aloksethi/nucleo_glue_board/README.md

# Nucleo Glue Board

A small pcb which sits on top of NUCLEO-F429ZI board.
It connects to the two morpho connectors (CN12 and CN11) and provides a handy way to connect to the power and RF board.
also provides 4 reference currents
