aloksethi/nucleo_glue_board/extension_board.pdf

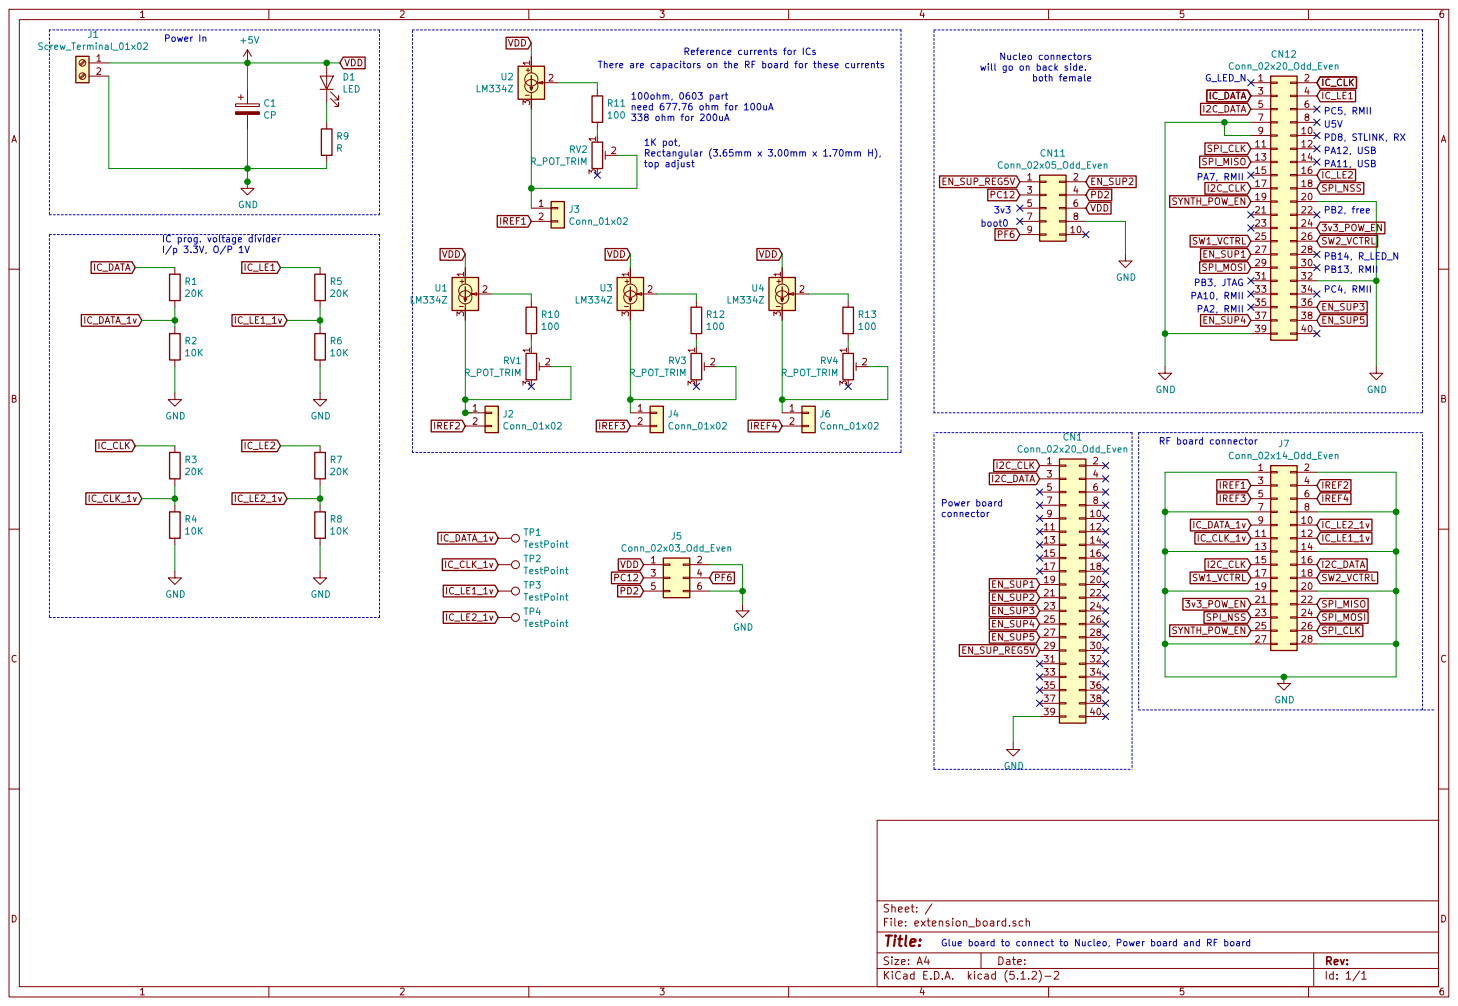
[picture p1: page 1]

boot0PF6 Reference currents for ICs TP1 TestPoint IC_DATA_1v

There are capacitors on the RF board for these currents

100ohm, 0603 part need 677.76 ohm for 100uA
338 ohm for 200uA

IC prog. voltage divider

Power board connector VDD

PB13, RMII PC4, RMII PA2, RMII PA10, RMII PB3, JTAG
