aloksethi/nucleo_glue_board/extension_board.kicad_pcb

## KiCad design extension_board.kicad_pcb (2021-06-22)

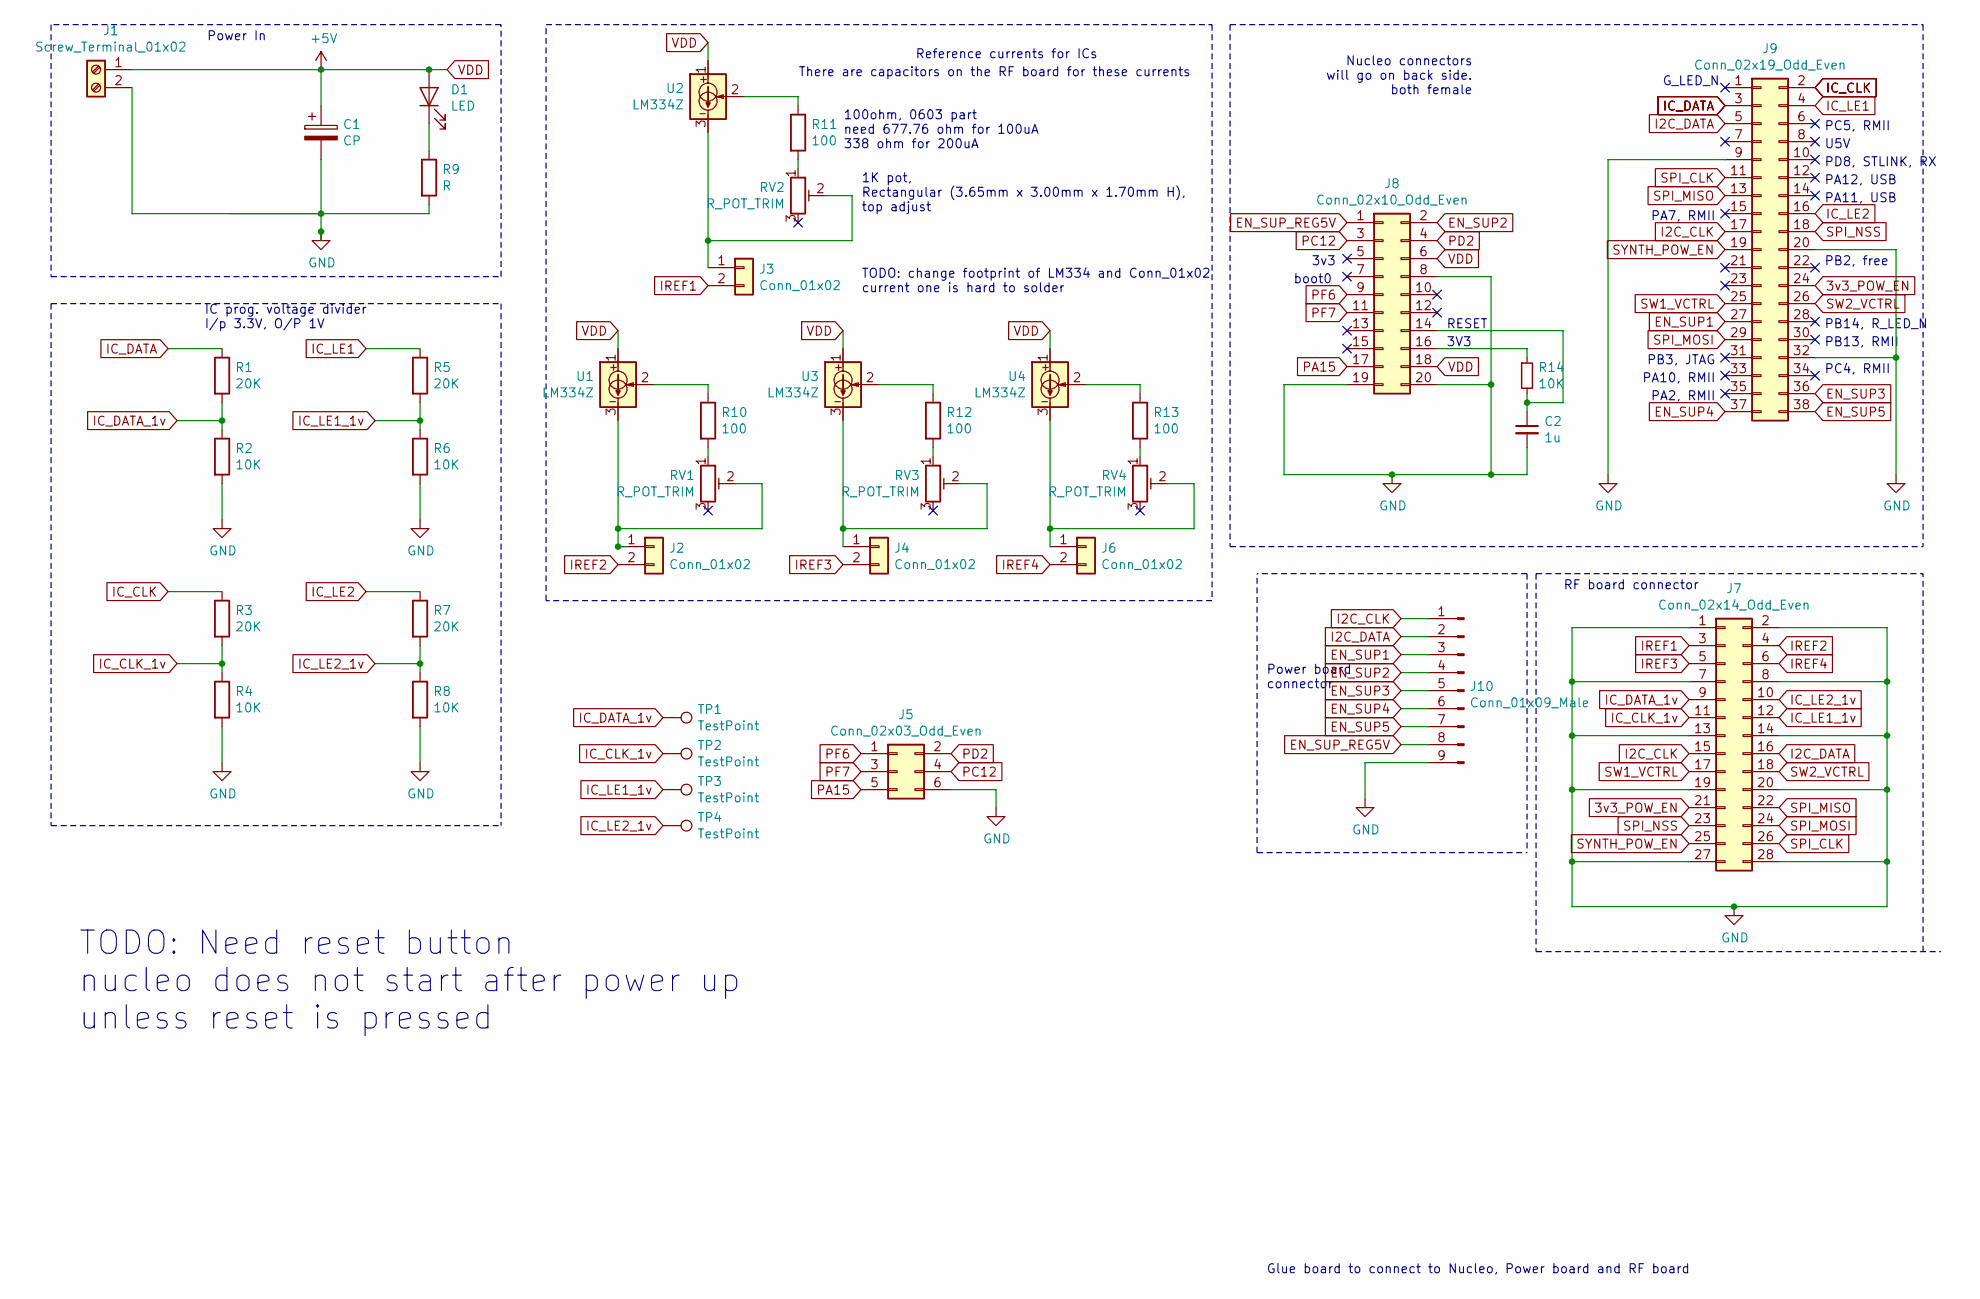
[picture p2: schematic extension_board.sch]

Parts:
C1: CP; CP_Elec_4x5.8
C2: 1u; C_0805_2012Metric_Pad1.15x1.40mm_HandSolder
D1: LED; LED_0805_2012Metric_Pad1.15x1.40mm_HandSolder
J1: Screw_Terminal_01x02; Term_Block_1x2_P5.08MM
J2, J3, J4, J6: Conn_01x02; PinHeader_1x02_P2.54mm_Vertical
J5: Conn_02x03_Odd_Even; PinHeader_2x03_P2.54mm_Vertical_SMD
J7: Conn_02x14_Odd_Even; PinHeader_2x14_P2.54mm_Vertical_SMD
J8: Conn_02x10_Odd_Even; PinHeader_2x10_P2.54mm_Vertical
J9: Conn_02x19_Odd_Even; PinHeader_2x19_P2.54mm_Vertical
J10: Conn_01x09_Male; PinHeader_1x09_P2.54mm_Vertical_SMD_Pin1Left
R1, R3, R5, R7: 20K; R_0805_2012Metric_Pad1.15x1.40mm_HandSolder
R2, R4, R6, R8, R14: 10K; R_0805_2012Metric_Pad1.15x1.40mm_HandSolder
R9: R; R_0805_2012Metric_Pad1.15x1.40mm_HandSolder
R10, R11, R12, R13: 100; R_0603_1608Metric_Pad1.05x0.95mm_HandSolder
RV1, RV2, RV3, RV4: R_POT_TRIM; Trimpot_3.8mmx3.6mm_TC33X-2-103E
TP1, TP2, TP3, TP4: TestPoint; TestPoint_Pad_1.0x1.0mm
U1, U2, U3, U4: LM334Z; TO-92_Inline_Wide

Connections:
3v3_POW_EN: J7.21, J9.24
EN_SUP1: J9.27, J10.3
EN_SUP2: J8.2, J10.4
EN_SUP3: J9.36, J10.5
EN_SUP4: J9.37, J10.6
EN_SUP5: J9.38, J10.7
EN_SUP_REG5V: J8.1, J10.8
GND: C1.2, C2.2, J1.2, J5.6, J7.1, J7.2, J7.7, J7.8, J7.13, J7.14, J7.19, J7.20, J7.27, J7.28, J8.8, J8.19, J8.20, J9.9, J9.20, J9.32, J10.9, R2.2, R4.2, R6.2, R8.2, R9.2
I2C_CLK: J7.15, J9.17, J10.1
I2C_DATA: J7.16, J9.5, J10.2
IC_CLK: J9.2, R3.1
IC_CLK_1v: J7.11, R3.2, R4.1, TP2.1
IC_DATA: J9.3, R1.1
IC_DATA_1v: J7.9, R1.2, R2.1, TP1.1
IC_LE1: J9.4, R5.1
IC_LE1_1v: J7.12, R5.2, R6.1, TP3.1
IC_LE2: J9.16, R7.1
IC_LE2_1v: J7.10, R7.2, R8.1, TP4.1
IREF1: J3.2, J7.3
IREF2: J2.2, J7.4
IREF3: J4.2, J7.5
IREF4: J6.2, J7.6
unnamed: C2.1, J8.14, R14.2
unnamed: D1.1 (K), R9.1
unnamed: J2.1, RV1.2, U1.3
unnamed: J3.1, RV2.2, U2.3
unnamed: J4.1, RV3.2, U3.3
unnamed: J6.1, RV4.2, U4.3
unnamed: J8.16, R14.1
unnamed: R10.1, U1.2
unnamed: R10.2, RV1.1
unnamed: R11.1, U2.2
unnamed: R11.2, RV2.1
unnamed: R12.1, U3.2
unnamed: R12.2, RV3.1
unnamed: R13.1, U4.2
unnamed: R13.2, RV4.1
PA15: J5.5, J8.17
PC12: J5.4, J8.3
PD2: J5.2, J8.4
PF6: J5.1, J8.9
PF7: J5.3, J8.11
SPI_CLK: J7.26, J9.11
SPI_MISO: J7.22, J9.13
SPI_MOSI: J7.24, J9.29
SPI_NSS: J7.23, J9.18
SW1_VCTRL: J7.17, J9.25
SW2_VCTRL: J7.18, J9.26
SYNTH_POW_EN: J7.25, J9.19
VDD: C1.1, D1.2 (A), J1.1, J8.6, J8.18, U1.1, U2.1, U3.1, U4.1

Notes on the sheet:
Glue board to connect to Nucleo, Power board and RF board
Power In
Nucleo connectors will go on back side. both female
RF board connector
IC prog. voltage divider I/p 3.3V, O/P 1V
100ohm, 0603 part need 677.76 ohm for 100uA 338 ohm for 200uA
1K pot, Rectangular (3.65mm x 3.00mm x 1.70mm H), top adjust
Power board connector
PC5, RMII
U5V
PD8, STLINK, RX
PA12, USB
PA11, USB
PB2, free
PB14, R_LED_N
G_LED_N
PB13, RMII
PC4, RMII
PA2, RMII
PA10, RMII
PB3, JTAG
PA7, RMII
3v3
boot0
Reference currents for ICs
There are capacitors on the RF board for these currents
TODO: change footprint of LM334 and Conn_01x02 current one is hard to solder
TODO: Need reset button nucleo does not start after power up unless reset is pressed
RESET
3V3

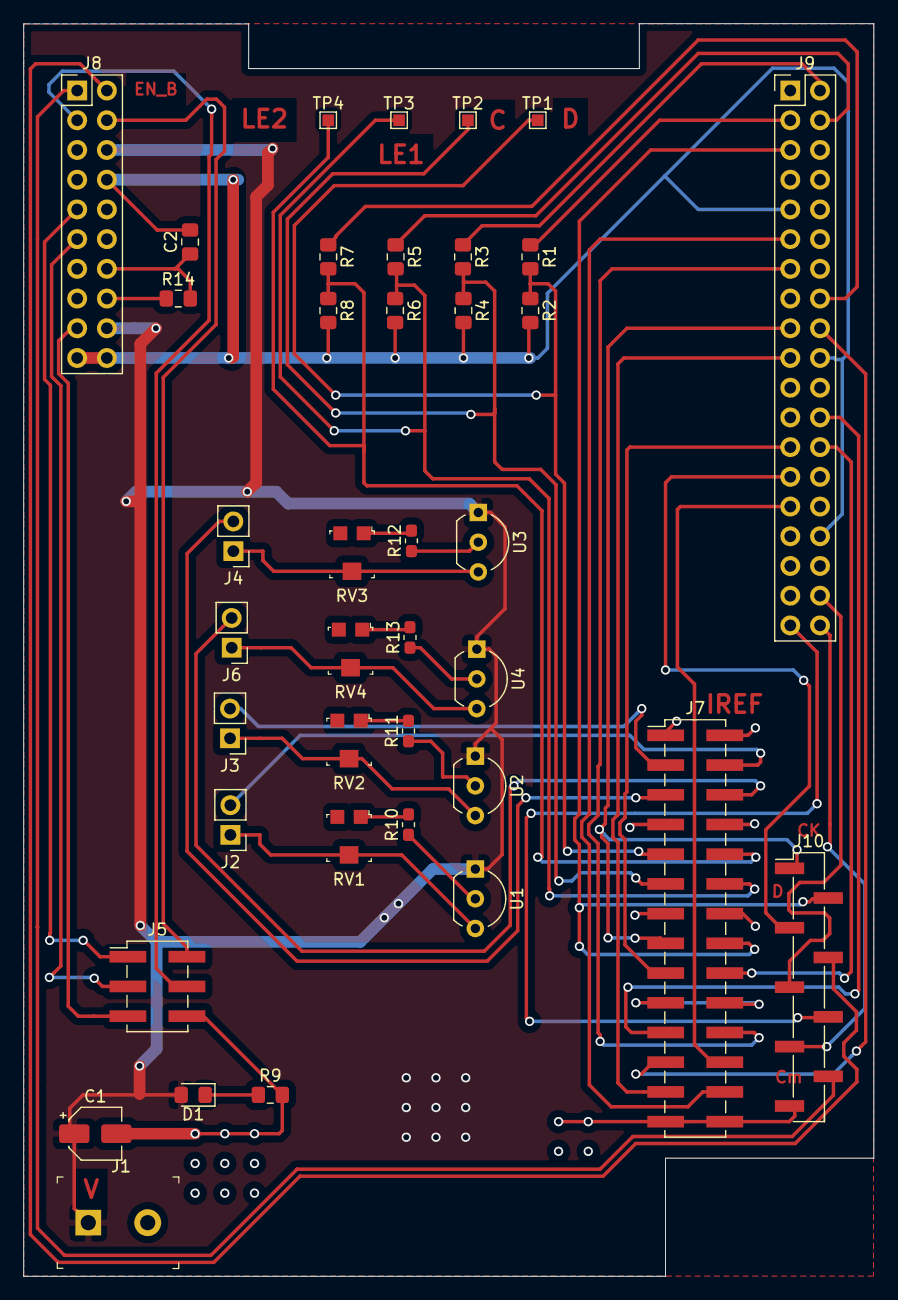
[picture p3: board extension_board.kicad_pcb from above]

Board: 2 copper layers, 72.7 x 107.1 mm, 39 parts (0 on the bottom side), 50 nets.
