aloksethi/nucleo_glue_board/(commit log)

2021-03-12 initial design
    [extension_board.kicad_pcb, extension_board.sch]
2021-03-16 first version of the pcb
    [extension_board.kicad_pcb, extension_board.sch]
2021-03-16 added labels on Top copper
    [extension_board.kicad_pcb]
2021-03-16 added gerber files
    [extension_board-B_Cu.gbr, extension_board-B_Mask.gbr, extension_board-B_Paste.gbr, extension_board-Edge_Cuts.gbr, extension_board-F_Cu.gbr, extension_board-F_Mask.gbr, extension_board-F_Paste.gbr, extension_board-NPTH.drl]
2021-04-13 had shorted gnd and AVDD on the cn12 connector
    [extension_board.kicad_pcb, extension_board.sch]
2021-06-20 changed footprint assignments, added reset circuit
    [extension_board.sch]
2021-06-22 gerber files and final files
    [extension_board.kicad_pcb, extension_board.sch]
2021-08-13 gerber filex for second pcb
    [extension_board-B_Cu.gbr, extension_board-B_Mask.gbr, extension_board-B_Paste.gbr, extension_board-B_SilkS.gbr, extension_board-Edge_Cuts.gbr, extension_board-F_Cu.gbr, extension_board-F_Mask.gbr, extension_board-F_Paste.gbr]
